f5vmr/QRM_Eliminator/new-front.jpg

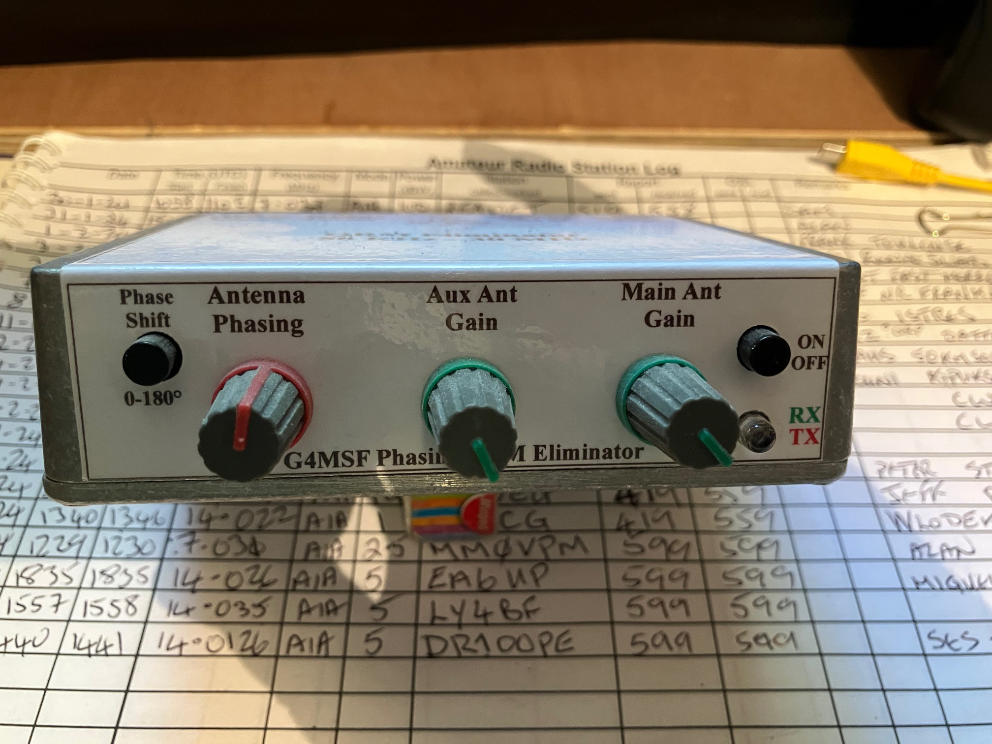
new-front.jpg
