f5vmr/QRM_Eliminator/new-pcb-bottom.jpg

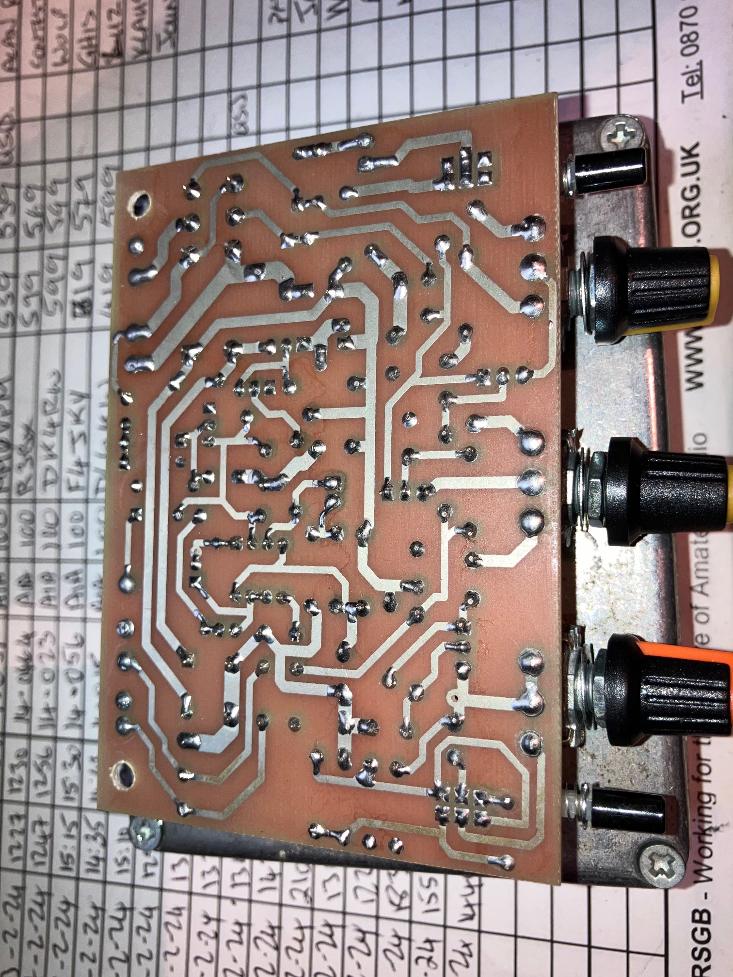
new-pcb-bottom.jpg
