f5vmr/QRM_Eliminator/README.md

A mistake in the downloaded zip file!!
The PCB is not designed with Diptrace but with KiCad and the version it was made with can be down loaded free from here - https://www.filehorse.com/download-kicad/55035/download/#google_vignette
