f5vmr/QRM_Eliminator/Large QRM PCB.jpg

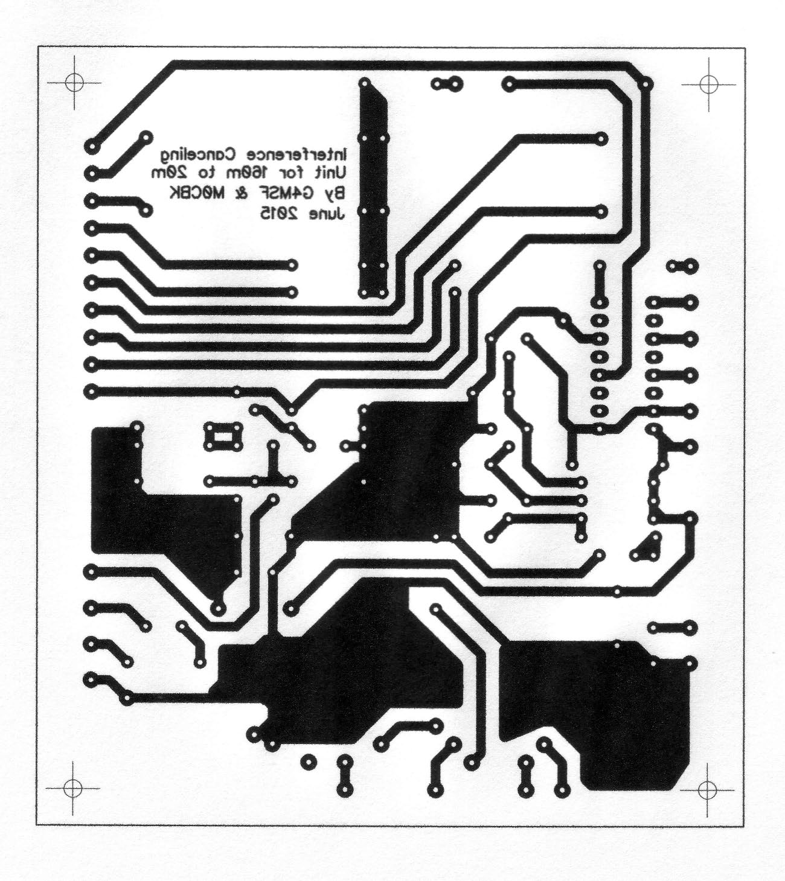
Large QRM PCB.jpg
