f5vmr/QRM_Eliminator/Large QRM PCB.tif

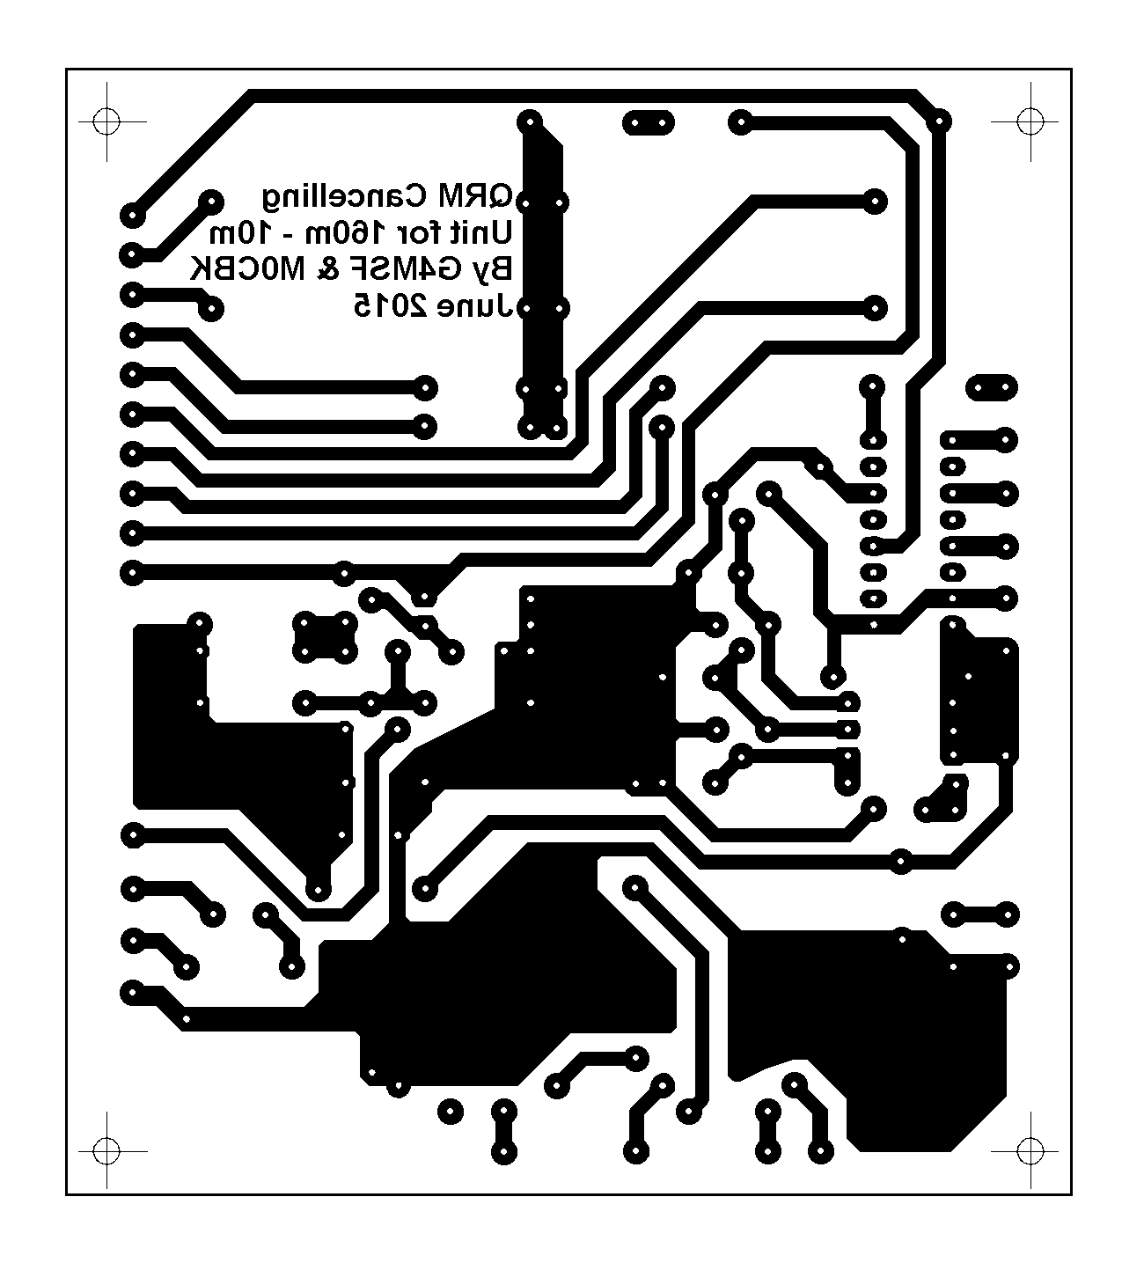
Large QRM PCB.tif
