f5vmr/QRM_Eliminator/new-back.jpg

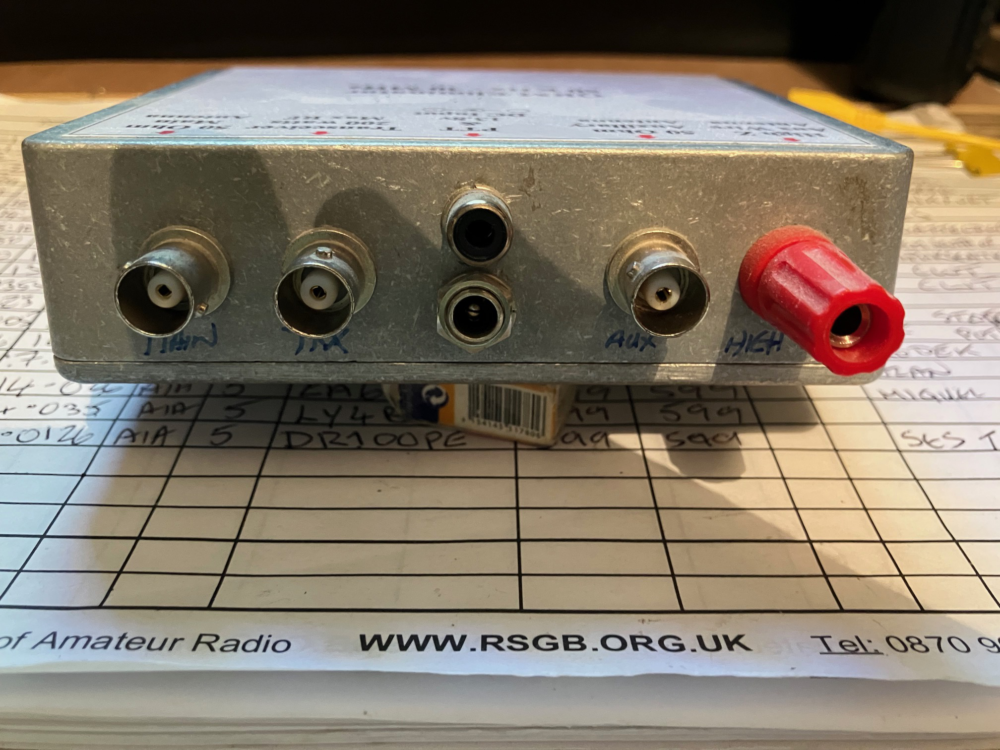
new-back.jpg
