f5vmr/QRM_Eliminator/new-inside.jpg

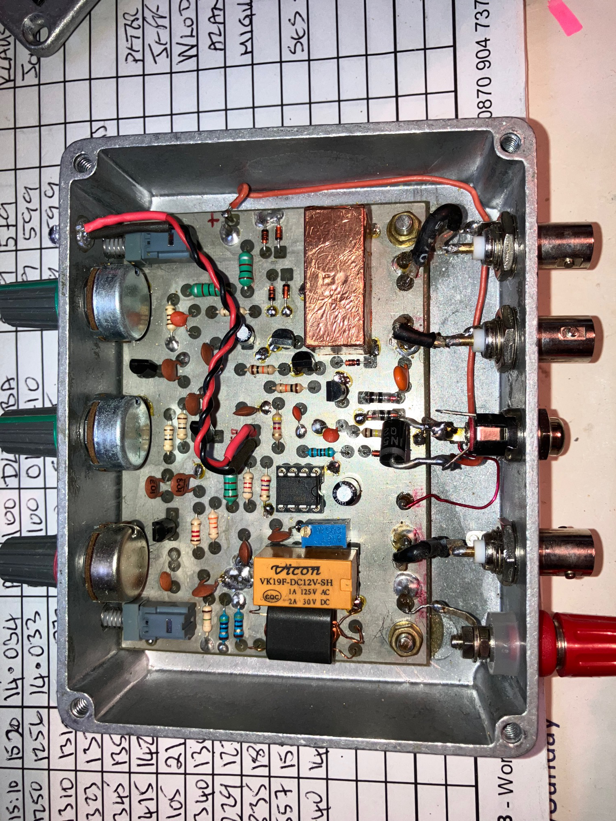
new-inside.jpg
