f5vmr/QRM_Eliminator/new-pcb-top.jpg

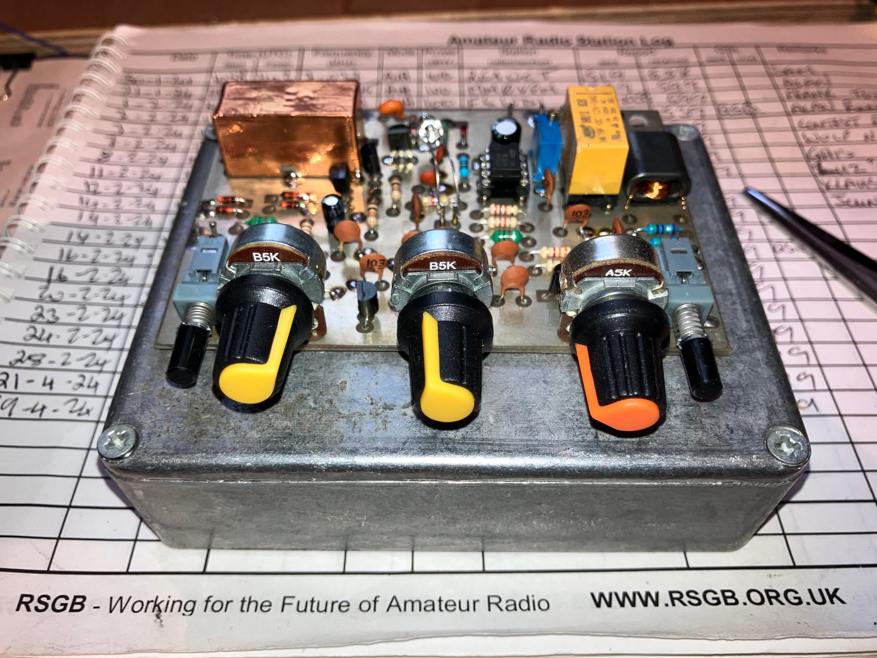
new-pcb-top.jpg
