f5vmr/QRM_Eliminator/New-QRM-Diagram.jpg

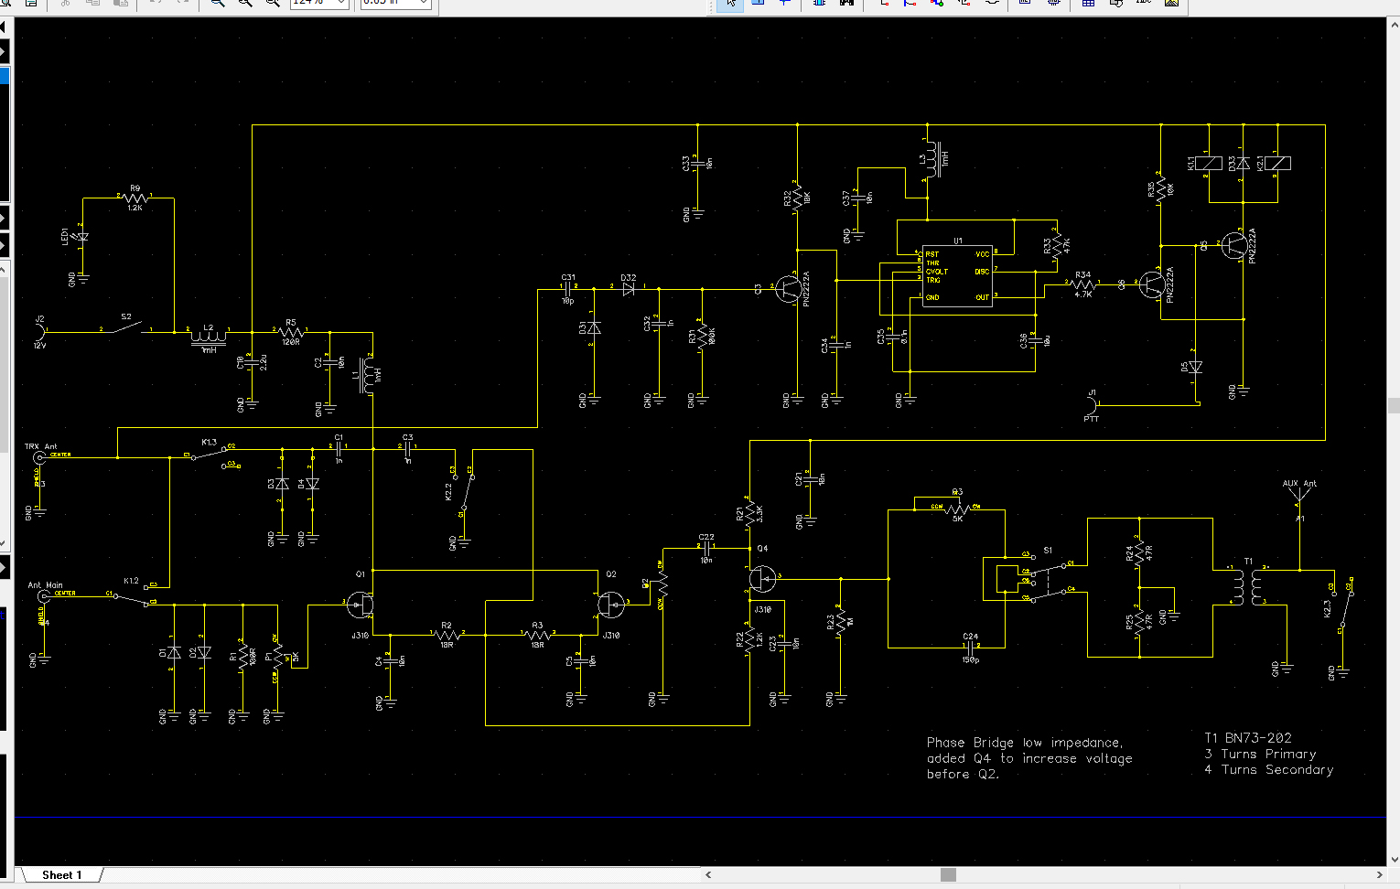
New-QRM-Diagram.jpg
