f5vmr/QRM_Eliminator/Schematic for big QRM Elim.jpg

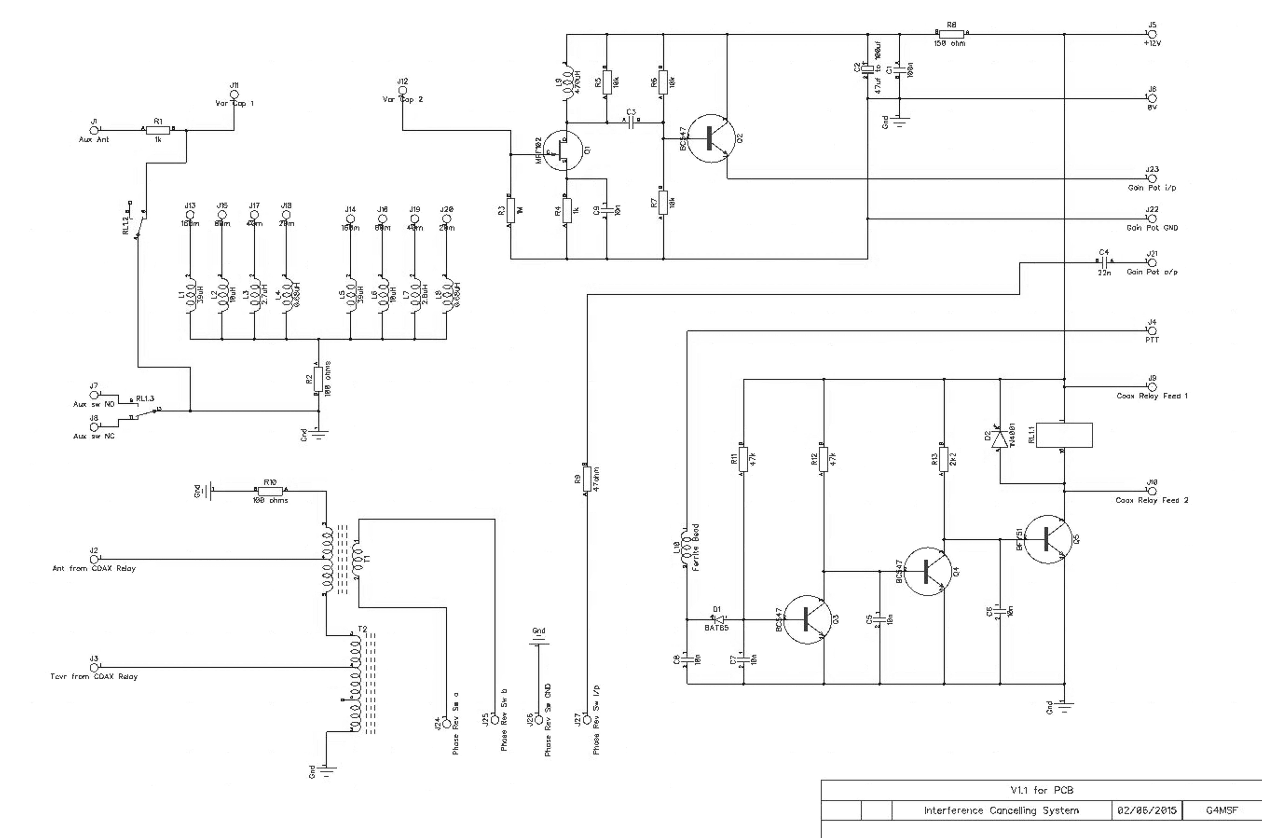
Schematic for big QRM Elim.jpg
