f5vmr/QRM_Eliminator/Keith Component-Layout.pdf

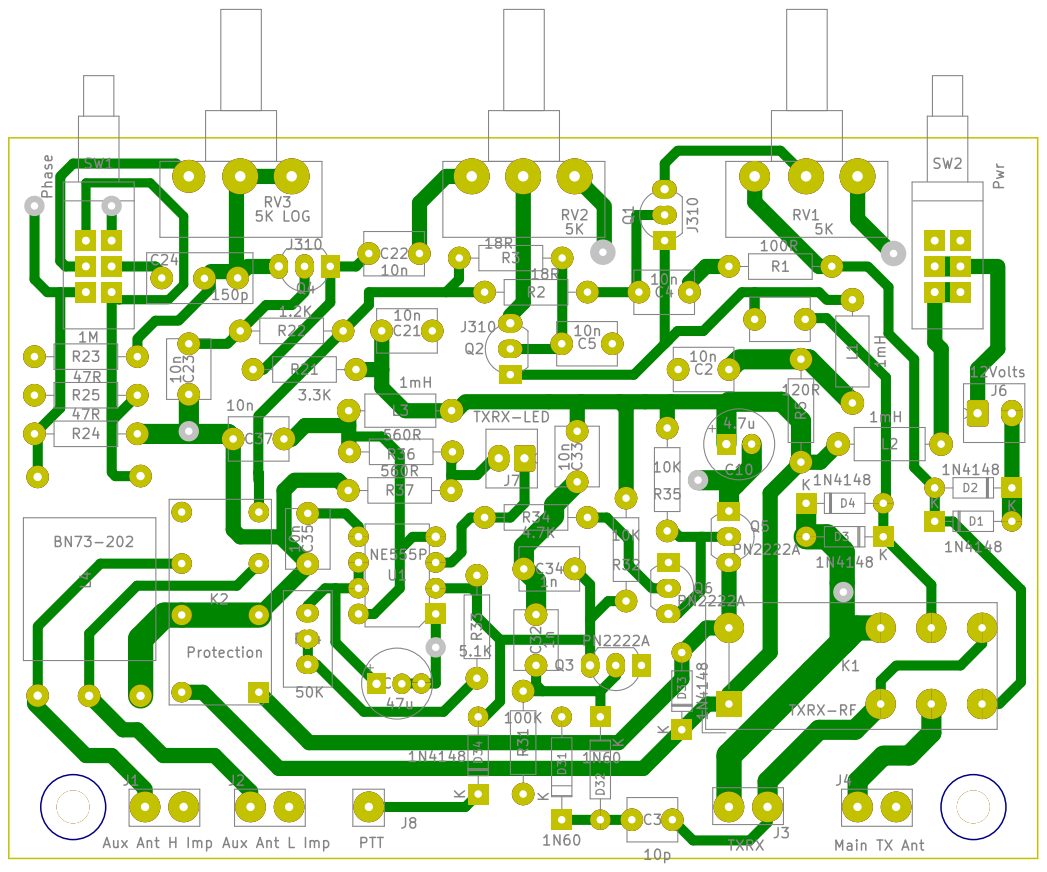
[picture p15: page 1]
