f5vmr/QRM_Eliminator/New-QRM-Elim Dip-Trace Files/Phase-xVer5.0.kicad_pcb

## KiCad design New-QRM-Elim Dip-Trace Files/Phase-xVer5.0.kicad_pcb (2025-05-26)

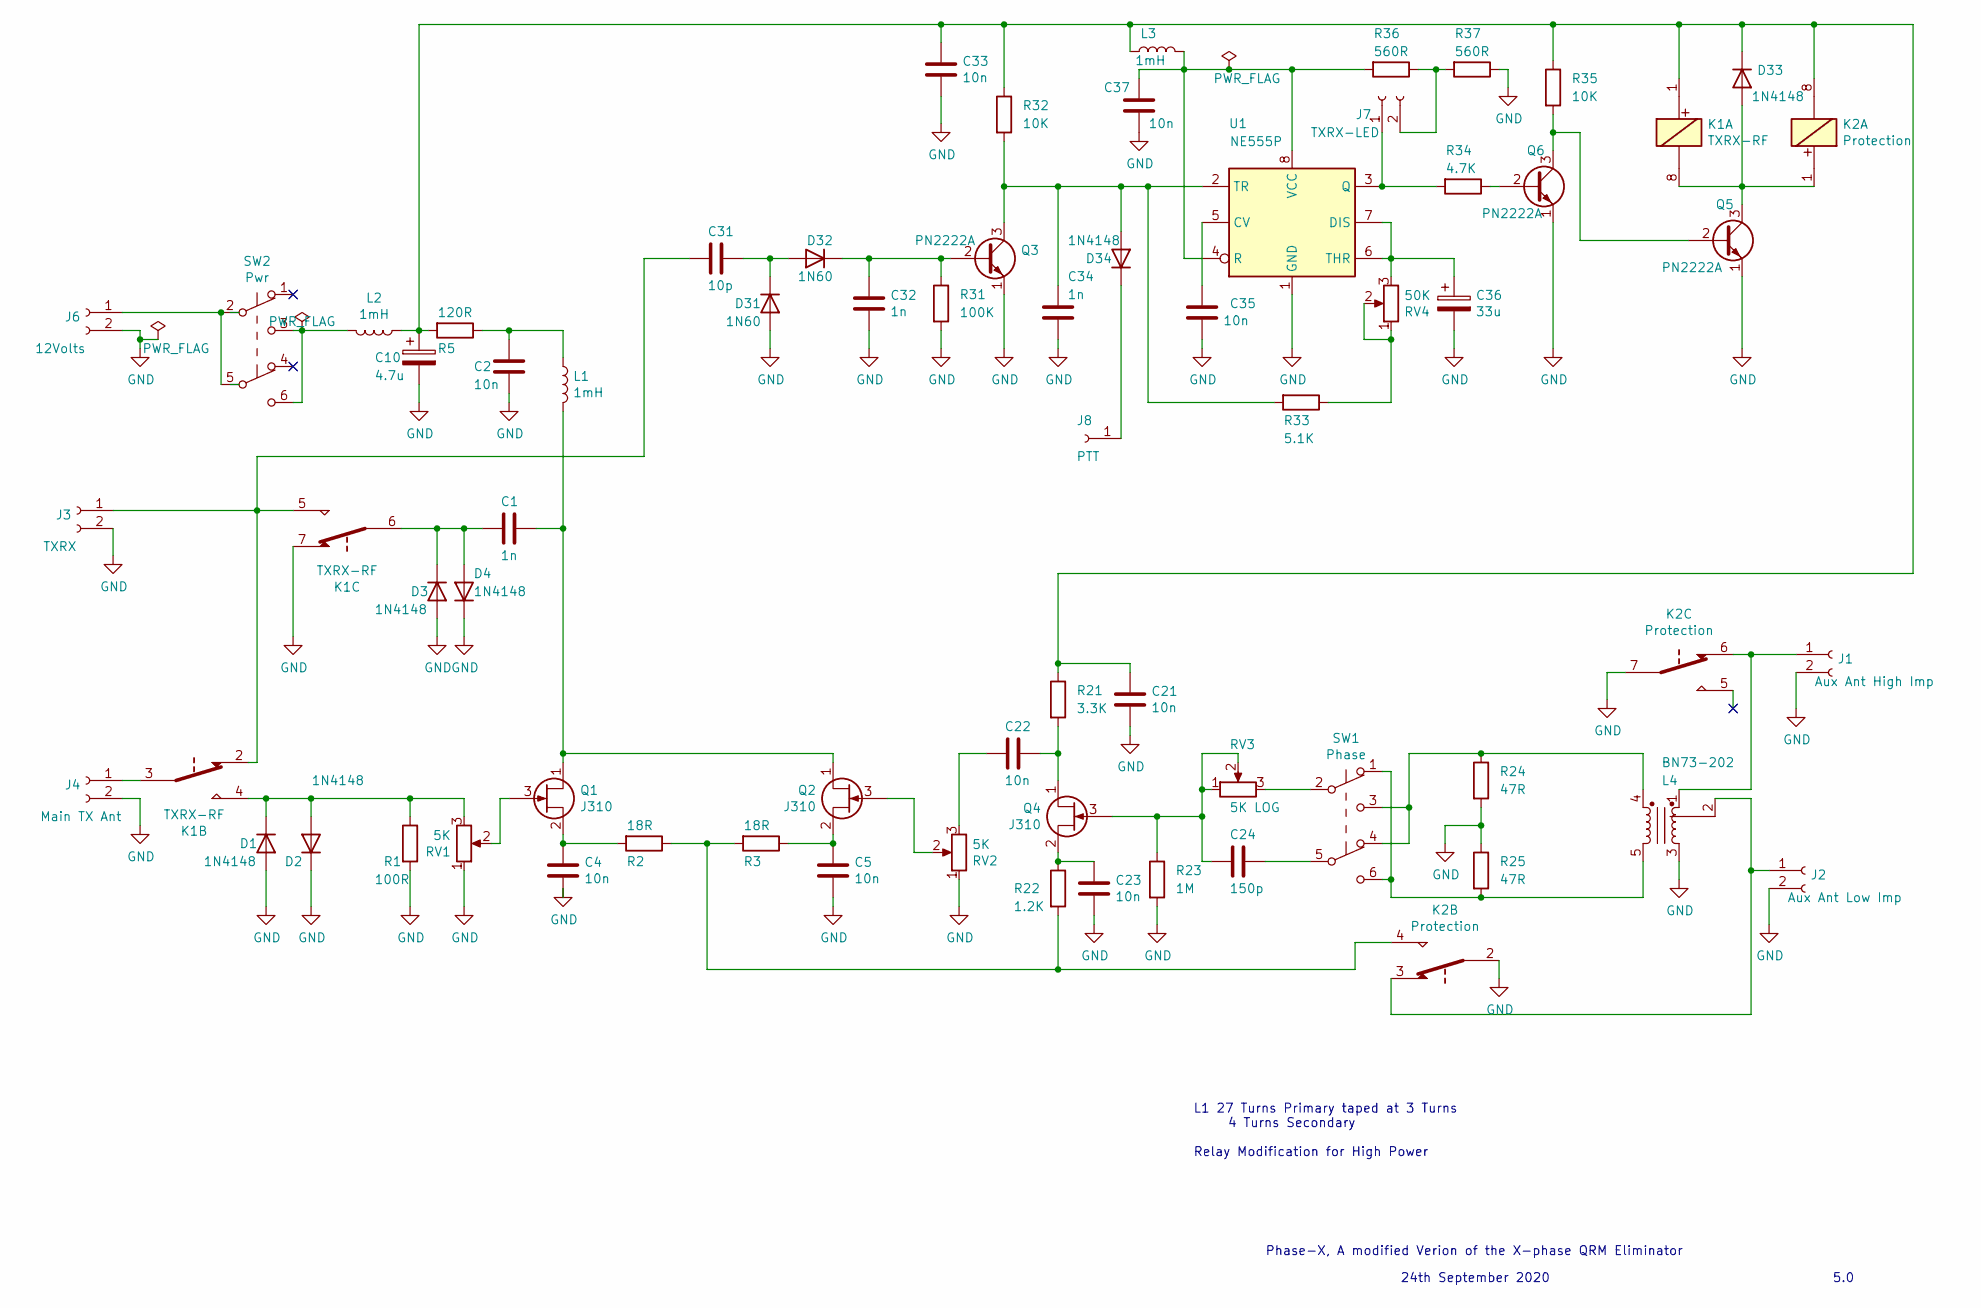
[picture p16: schematic Phase-xVer5.0.sch]

Parts:
C1, C32, C34: 1n; CeramicDisc_P5.0mm
C2, C4, C5, C21, C22, C23, C33, C35, C37: 10n; CeramicDisc_P5.0mm
C10: 4.7u; Small_Tant_Elect
C24: 150p; CeramicDisc_P7.5_3pin
C31: 10p; CeramicDisc_P5.0mm
C36: 33u; Small_Tant_Elect
D1, D2, D3, D4, D33, D34: 1N4148; Signal_Diode
D31, D32: 1N60; Signal_Diode
J1: Aux Ant High Imp; Connector
J2: Aux Ant Low Imp; Connector
J3: TXRX; Connector
J4: Main TX Ant; Connector
J6: 12Volts; 2Pin_Molex
J7: TXRX-LED; 2Pin_Molex
J8: PTT; SingleConnector
K1: TXRX-RF; Relay_DPDT_Omron_G2RL
K2: Protection; Relay_DPDT_Omron
L1, L2, L3: 1mH; Inductor
L4: BN73-202
Q1, Q2, Q4: J310; TO-92_Wide
Q3, Q5, Q6: PN2222A; TO-92_Wide
R1: 100R; R_L6.3mm__P10.16mm_Pad2.2mm
R2, R3: 18R; R_L6.3mm__P10.16mm_Pad2.2mm
R5: 120R; R_L6.3mm__P10.16mm_Pad2.2mm
R21: 3.3K; R_L6.3mm__P10.16mm_Pad2.2mm
R22: 1.2K; R_L6.3mm__P10.16mm_Pad2.2mm
R23: 1M; R_L6.3mm__P10.16mm_Pad2.2mm
R24, R25: 47R; R_L6.3mm__P10.16mm_Pad2.2mm
R31: 100K; R_L6.3mm__P10.16mm_Pad2.2mm
R32, R35: 10K; R_L6.3mm__P10.16mm_Pad2.2mm
R33: 5.1K; R_L6.3mm__P10.16mm_Pad2.2mm
R34: 4.7K; R_L6.3mm__P10.16mm_Pad2.2mm
R36, R37: 560R; R_L6.3mm__P10.16mm_Pad2.2mm
RV1, RV2: 5K; Potentiometer_T-16H_Single_Horizontal
RV3: 5K LOG; Potentiometer_T-16H_Single_Horizontal
RV4: 50K; Preset
SW1: Phase; SW_Push_DPDT-P0.1mil
SW2: Pwr; SW_Push_DPDT-P0.1mil
U1: NE555P; DIP8

Connections:
GND: C2.2, C4.2, C5.2, C10.2, C21.2, C23.2, C32.2, C33.2, C34.2, C35.2, C36.2, C37.2, D1.2 (A), D2.1 (K), D3.2 (A), D4.1 (K), D31.2 (A), J1.2, J2.2, J3.2, J4.2, J6.2, K1.7, K2.2, K2.7, L4.3, Q3.1 (E), Q5.1 (E), Q6.1 (E), R1.2, R23.2, R24.2, R25.1, R31.2, R37.1, RV1.1, RV2.1, U1.1 (GND)
unnamed: C1.1, L1.2, Q1.1 (D), Q2.1 (D)
unnamed: C1.2, D3.1 (K), D4.2 (A), K1.6
unnamed: C2.1, L1.1, R5.1
unnamed: C4.1, Q1.2 (S), R2.2
unnamed: C5.1, Q2.2 (S), R3.1
unnamed: C10.1, C21.1, C33.1, D33.1 (K), K1.1, K2.8, L2.1, L3.1, R5.2, R21.1, R32.1, R35.1
unnamed: C22.1, Q4.1 (D), R21.2
unnamed: C22.2, RV2.3
unnamed: C23.1, Q4.2 (S), R22.1
unnamed: C24.1, SW1.5 (B)
unnamed: C24.2, Q4.3 (G), R23.1, RV3.1, RV3.2
unnamed: C31.1, D31.1 (K), D32.2 (A)
unnamed: C31.2, J3.1, K1.2, K1.5
unnamed: C32.1, D32.1 (K), Q3.2 (B), R31.1
unnamed: C34.1, D34.2 (A), Q3.3 (C), R32.2, R33.2, U1.2 (TR)
unnamed: C35.1, U1.5 (CV)
unnamed: C36.1, RV4.3, U1.6 (THR), U1.7 (DIS)
unnamed: C37.1, L3.2, R36.2, U1.4 (R), U1.8 (VCC)
unnamed: D1.1 (K), D2.2 (A), K1.4, R1.1, RV1.3
unnamed: D33.2 (A), K1.8, K2.1, Q5.3 (C)
unnamed: D34.1 (K), J8.1
unnamed: J1.1, K2.6, L4.1
unnamed: J2.1, K2.3, L4.2
unnamed: J4.1, K1.3
unnamed: J6.1, SW2.2 (B), SW2.5 (B)
unnamed: J7.1, R34.2, U1.3 (Q)
unnamed: J7.2, R36.1, R37.2
unnamed: K2.4, R2.1, R3.2, R22.2
unnamed: L2.2, SW2.3 (C), SW2.6 (C)
unnamed: L4.4, R24.1, SW1.3 (C), SW1.4 (A)
unnamed: L4.5, R25.2, SW1.1 (A), SW1.6 (C)
unnamed: Q1.3 (G), RV1.2
unnamed: Q2.3 (G), RV2.2
unnamed: Q5.2 (B), Q6.3 (C), R35.2
unnamed: Q6.2 (B), R34.1
unnamed: R33.1, RV4.1, RV4.2
unnamed: RV3.3, SW1.2 (B)

Notes on the sheet:
L1 27 Turns Primary taped at 3 Turns 4 Turns Secondary Relay Modification for High Power
Phase-X, A modified Verion of the X-phase QRM Eliminator
5.0
24th September 2020

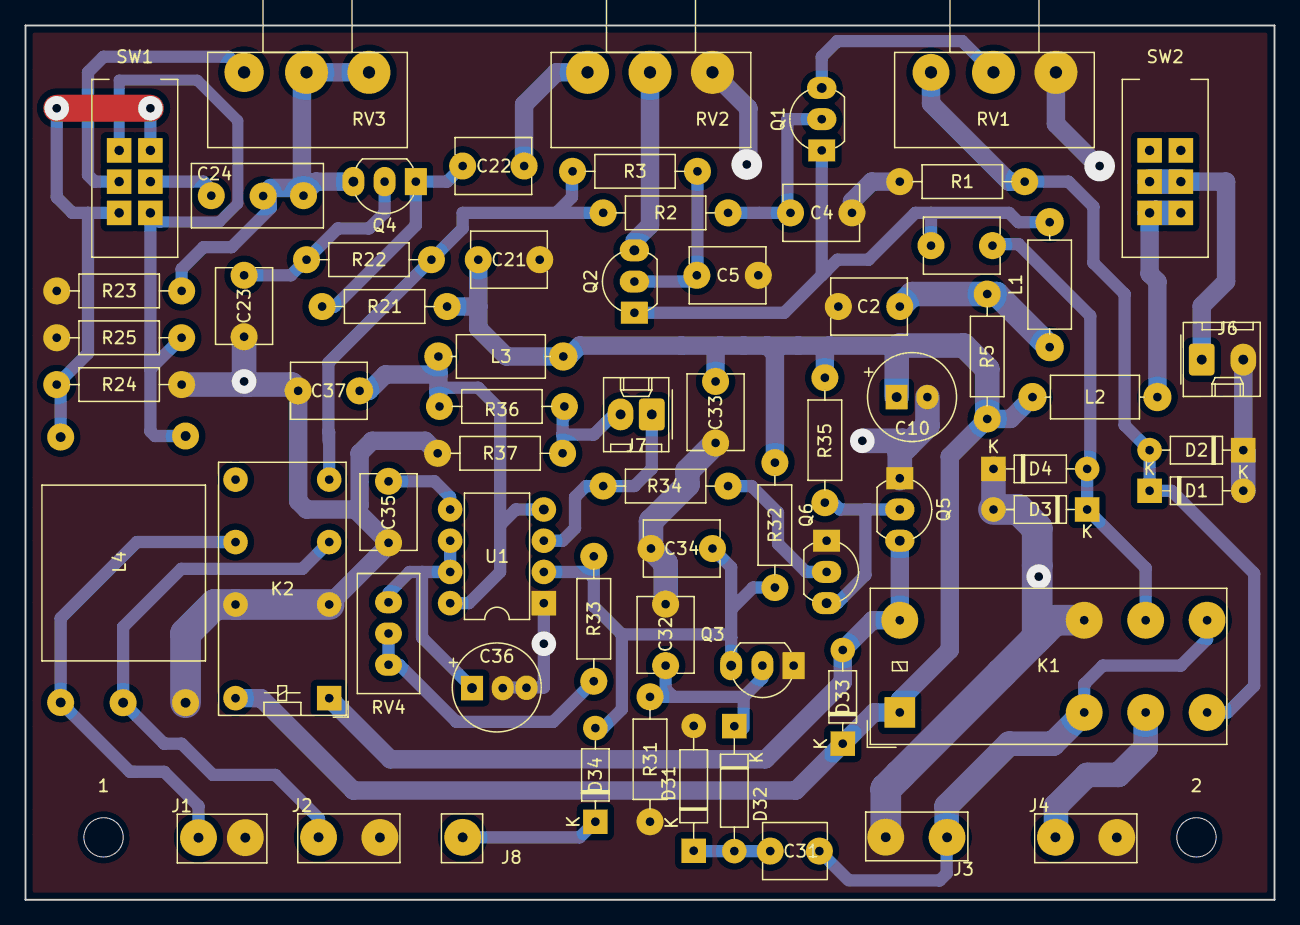
[picture p17: board Phase-xVer5.0.kicad_pcb from above]

Board: 2 copper layers, 101.6 x 71.1 mm, 67 parts (0 on the bottom side), 38 nets.

Other parts of the board:
1, 2: M3; MountingHole_3.2mm_M3
